ac212289-dev/PI-ups/README.md

Designed a UPS PCB using 18650 batteries

Integrated charging, protection, and USB I/O

Focused on efficient power routing and compact layout
