ac212289-dev/PI-ups/USB_UPS_Raspberry.kicad_pcb

## KiCad design USB_UPS_Raspberry.kicad_pcb (2026-04-15)

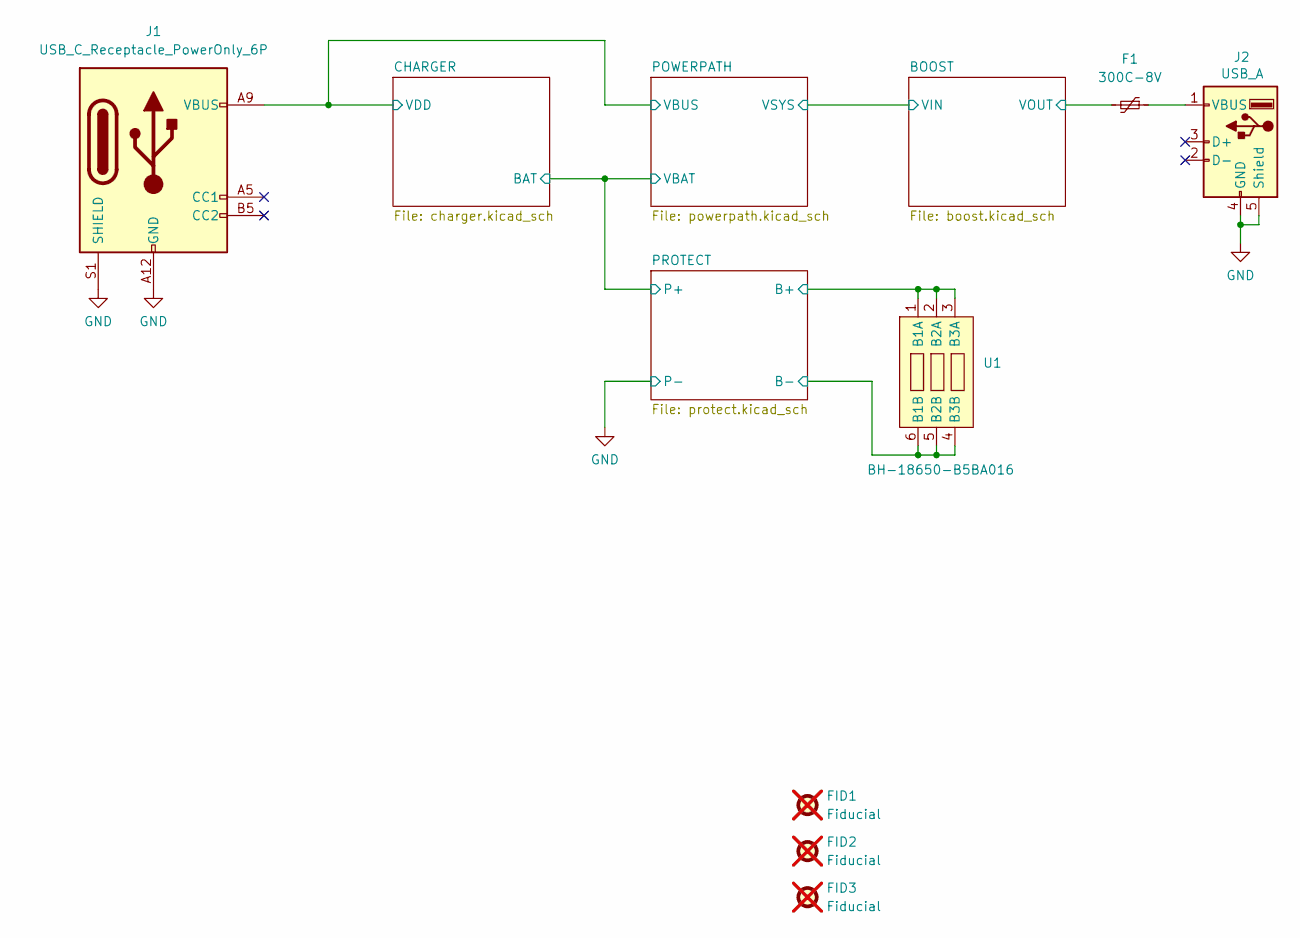
[picture p1: schematic USB_UPS_Raspberry.kicad_sch, USB UPS 18650]

Parts:
F1: 300C-8V; Fuse_1206_3216Metric; MPN# SMD1206-300C-8V
FID1, FID2, FID3: Fiducial; Fiducial_0.5mm_Mask1mm; not fitted
J1: USB_C_Receptacle_PowerOnly_6P; USB_C_Receptacle_HRO_TYPE-C-31-M-17; MPN# GT-USB-7002A
J2: USB_A; USB_A_Connfly_DS1095; MPN# DS1095-BNR0
U1: BH-18650-B5BA016; MPN# BH-18650-B5BA016

Connections:
/BOOST/VOUT: F1.2; also elsewhere on the board
/CHARGER/VDD: J1.A9 (VBUS), J1.B9 (VBUS); also elsewhere on the board
/PROTECT/B+: U1.1 (B1A), U1.2 (B2A), U1.3 (B3A); also elsewhere on the board
/PROTECT/B-: U1.4 (B3B), U1.5 (B2B), U1.6 (B1B); also elsewhere on the board
GND: J1.A12 (GND), J1.B12 (GND), J1.S1 (SHIELD), J2.4 (GND), J2.5 (Shield); also elsewhere on the board
unnamed: F1.1, J2.1 (VBUS)

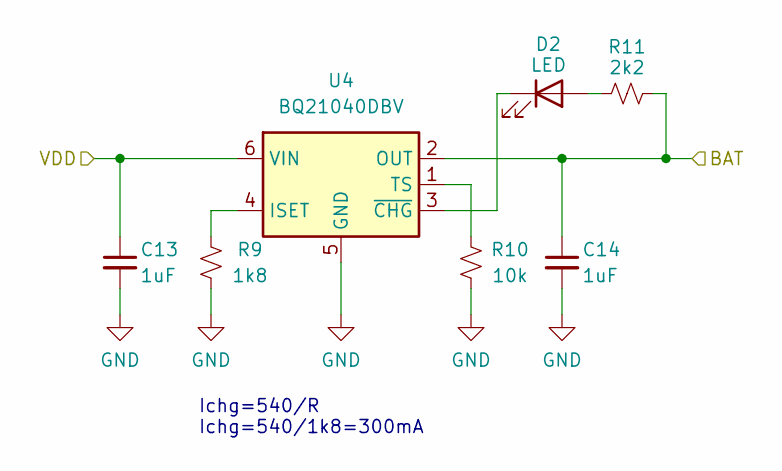
[picture p2: schematic charger.kicad_sch, PI UPS]

Parts:
C13, C14: 1uF; C_0603_1608Metric; MPN# CC0603KRX5R8BB105
D2: LED; LED_0603_1608Metric; MPN# LTST-C193KSKT-5A
R9: 1k8; R_0603_1608Metric; MPN# RT0603BRD071K8L
R10: 10k; R_0603_1608Metric; MPN# RT0603BRD0710KL
R11: 2k2; R_0603_1608Metric; MPN# RT0603BRD072K2L
U4: BQ21040DBV; SOT-23-6; MPN# BQ21040DBVR

Connections:
/CHARGER/BAT: C14.1, R11.1, U4.2 (OUT); also elsewhere on the board
/CHARGER/VDD: C13.1, U4.6 (VIN); also elsewhere on the board
GND: C13.2, C14.2, R9.2, R10.2, U4.5 (GND); also elsewhere on the board
unnamed: D2.2 (A), R11.2
unnamed: D2.1 (K), U4.3 (~CHG)
unnamed: R9.1, U4.4 (ISET)
unnamed: R10.1, U4.1 (TS)

Notes on the sheet:
Ichg=540/R Ichg=540/1k8=300mA

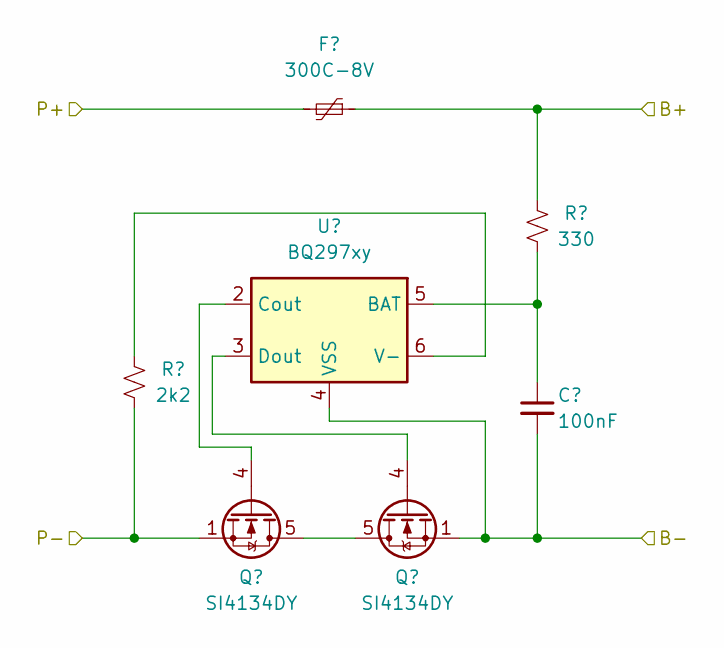
[picture p3: schematic protect.kicad_sch, PI UPS]

Parts:
C12: 100nF; C_0603_1608Metric; MPN# CC0603KRX7R8BB104
F2: 300C-8V; Fuse_1206_3216Metric; MPN# SMD1206-300C-8V
Q2, Q3: SI4134DY; SOIC-8_3.9x4.9mm_P1.27mm; MPN# SI4134DY-T1-GE3
R7: 2k2; R_0603_1608Metric; MPN# RT0603BRD072K2L
R8: 330; R_0603_1608Metric; MPN# RT0603BRE07330RL
U3: BQ297xy; WSON-6_1.5x1.5mm_P0.5mm; MPN# BQ29700DSER

Connections:
/CHARGER/BAT: F2.2; also elsewhere on the board
/PROTECT/B+: F2.1, R8.1; also elsewhere on the board
/PROTECT/B-: C12.2, Q3.1 (S), Q3.2 (S), Q3.3 (S), U3.4 (VSS); also elsewhere on the board
GND: Q2.1 (S), Q2.2 (S), Q2.3 (S), R7.2; also elsewhere on the board
unnamed: Q2.5 (D), Q2.6 (D), Q2.7 (D), Q2.8 (D), Q3.5 (D), Q3.6 (D), Q3.7 (D), Q3.8 (D)
unnamed: Q2.4 (G), U3.2 (Cout)
unnamed: Q3.4 (G), U3.3 (Dout)
unnamed: C12.1, R8.2, U3.5 (BAT)
unnamed: R7.1, U3.6 (V-)

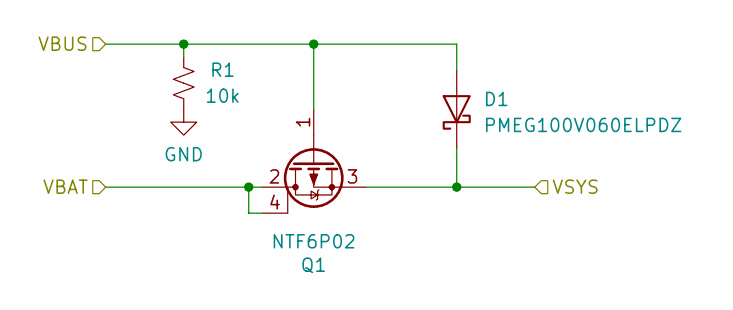
[picture p4: schematic powerpath.kicad_sch, PI UPS]

Parts:
D1: PMEG100V060ELPDZ; Nexperia_CFP15_SOT-1289; MPN# PMEG100V060ELPDZ
Q1: NTF6P02; SOT-223-3_TabPin2; MPN# NTF6P02T3G
R1: 10k; R_0603_1608Metric; MPN# RT0603BRD0710KL

Connections:
/BOOST/VIN: D1.3 (K), Q1.3 (S); also elsewhere on the board
/CHARGER/BAT: Q1.2 (D), Q1.4 (D); also elsewhere on the board
/CHARGER/VDD: D1.1 (A), D1.2 (A), Q1.1 (G), R1.1; also elsewhere on the board
GND: R1.2; also elsewhere on the board

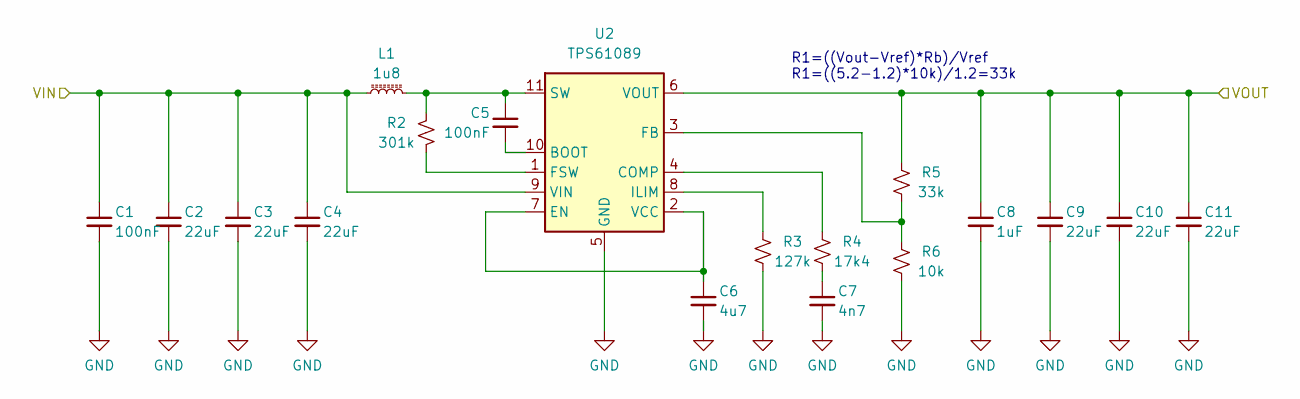
[picture p5: schematic boost.kicad_sch, PI ups]

Parts:
C1, C5: 100nF; C_0603_1608Metric; MPN# CC0603KRX7R8BB104
C2, C3, C4, C9, C10, C11: 22uF; C_0603_1608Metric; MPN# GRM188R61C226ME01D
C6: 4u7; C_0603_1608Metric; MPN# GRM188R61E475KE11D
C7: 4n7; C_0603_1608Metric; MPN# CC0603KRX7R8BB472
C8: 1uF; C_0603_1608Metric; MPN# CC0603KRX5R8BB105
L1: 1u8; L_Bourns_SRP6060FA; MPN# YSPIT0630A-1R8M
R2: 301k; R_0603_1608Metric; MPN# RT0603BRE07301KL
R3: 127k; R_0603_1608Metric; MPN# RT0603FRE07127KL
R4: 17k4; R_0603_1608Metric; MPN# RT0603BRD0717K4L
R5: 33k; R_0603_1608Metric; MPN# RT0603BRD0733KL
R6: 10k; R_0603_1608Metric; MPN# RT0603BRD0710KL
U2: TPS61089; Texas_VQFN-RNR0011A-11; MPN# TPS61089RNRR

Connections:
/BOOST/VIN: C1.1, C2.1, C3.1, C4.1, L1.1, U2.9 (VIN); also elsewhere on the board
/BOOST/VOUT: C8.1, C9.1, C10.1, C11.1, R5.1, U2.6 (VOUT); also elsewhere on the board
GND: C1.2, C2.2, C3.2, C4.2, C6.2, C7.2, C8.2, C9.2, C10.2, C11.2, R3.2, R6.2, U2.5 (GND); also elsewhere on the board
unnamed: C7.1, R4.2
unnamed: C5.2, U2.10 (BOOT)
unnamed: R4.1, U2.4 (COMP)
unnamed: C6.1, U2.2 (VCC), U2.7 (EN)
unnamed: R5.2, R6.1, U2.3 (FB)
unnamed: R2.2, U2.1 (FSW)
unnamed: R3.1, U2.8 (ILIM)
unnamed: C5.1, L1.2, R2.1, U2.11 (SW)

Notes on the sheet:
R1=((Vout-Vref)*Rb)/Vref R1=((5.2-1.2)*10k)/1.2=33k

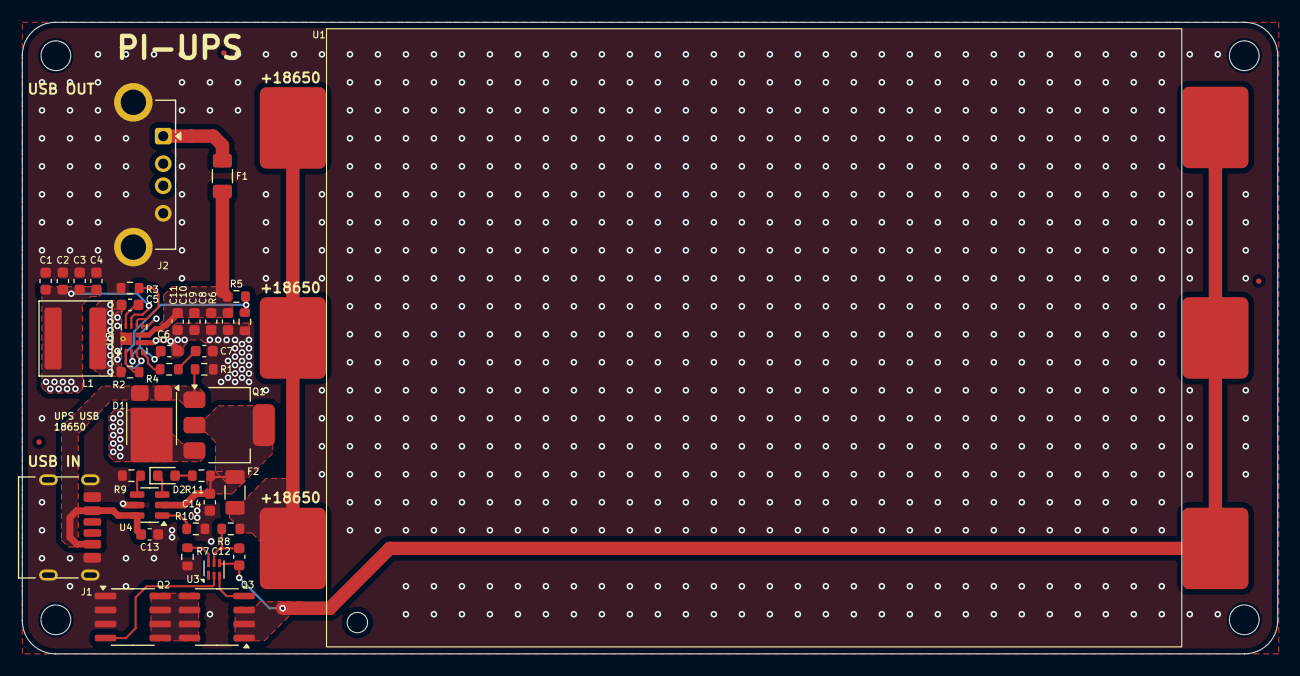
[picture p6: board USB_UPS_Raspberry.kicad_pcb from above]

Board: 2 copper layers, 113.9 x 57.3 mm, 42 parts (0 on the bottom side), 25 nets.
